DYB2363021436/NREL_5MW/NREL-5MW.STEP

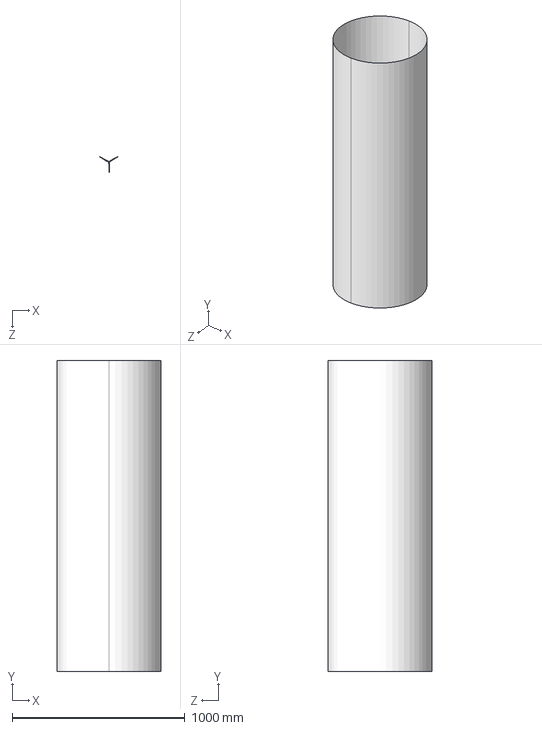
[picture p11: CAD file, 2023-11-30]
NREL-5MW.STEP
600.0 x 1800.0 x 600.0 mm
