DYB2363021436/NREL_5MW/塔筒.SLDPRT

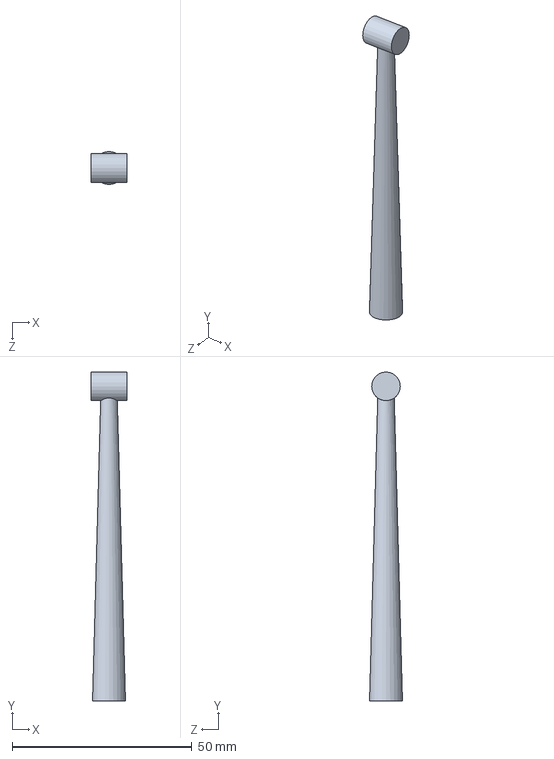
[picture p12: CAD file, 2023-11-30]
塔筒.SLDPRT
10.0 x 91.6 x 9.18 mm
