DYB2363021436/NREL_5MW/(list of files, cad)

Other CAD files:
NREL-5MW.SLDASM
NREL-5MW.SLDPRT
